thotypous/ll14x-power-supply/imagens/referencias/D_NQ_NP_2X_678878-MLA81993519998_022025-F-placa-potencia-lava-louca-ll10x-ll10b-a21846701-220v.webp

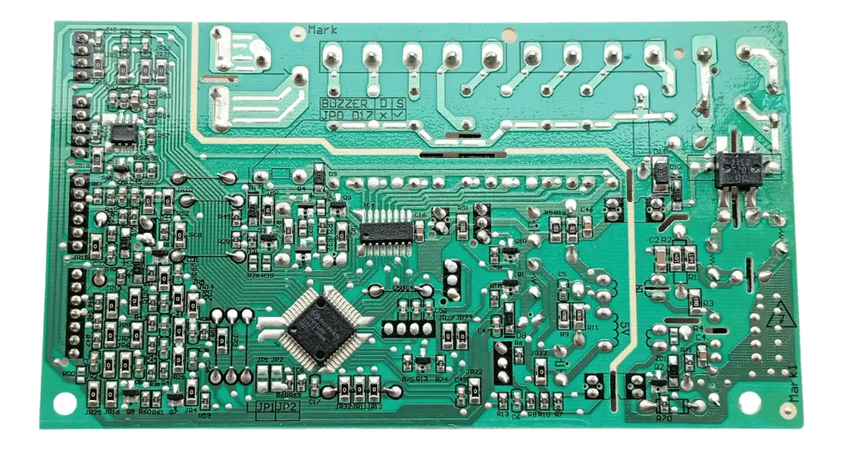
imagens/referencias/D_NQ_NP_2X_678878-MLA81993519998_022025-F-placa-potencia-lava-louca-ll10x-ll10b-a21846701-220v.webp
