thotypous/ll14x-power-supply/imagens/referencias/D_NQ_NP_2X_937345-MLB83347727536_042025-F-placa-lava-louca-electrolux--wqp127601sd11-v11.webp

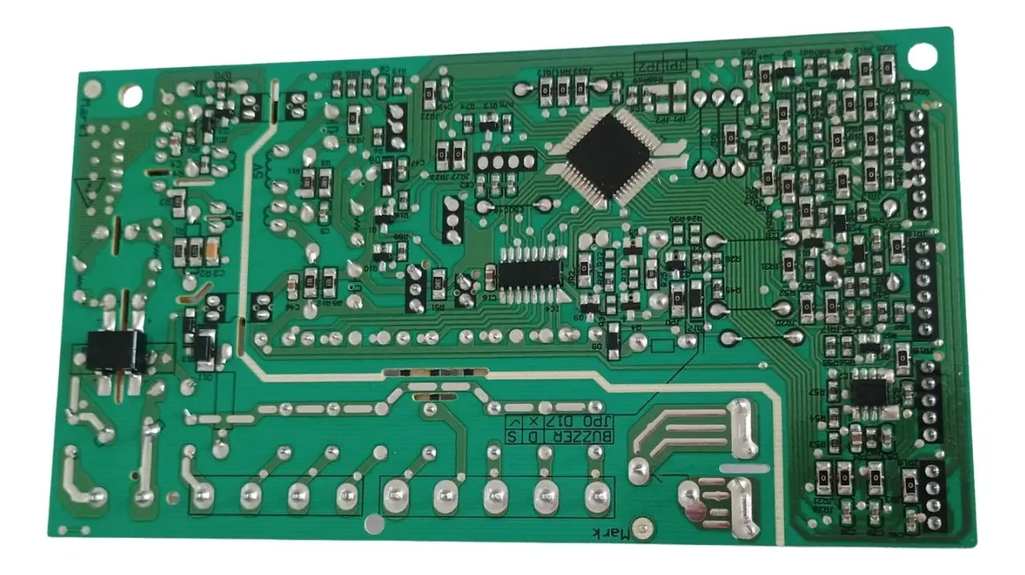
imagens/referencias/D_NQ_NP_2X_937345-MLB83347727536_042025-F-placa-lava-louca-electrolux--wqp127601sd11-v11.webp
