thotypous/ll14x-power-supply/imagens/originais/PXL_20260823_020516982.jpg

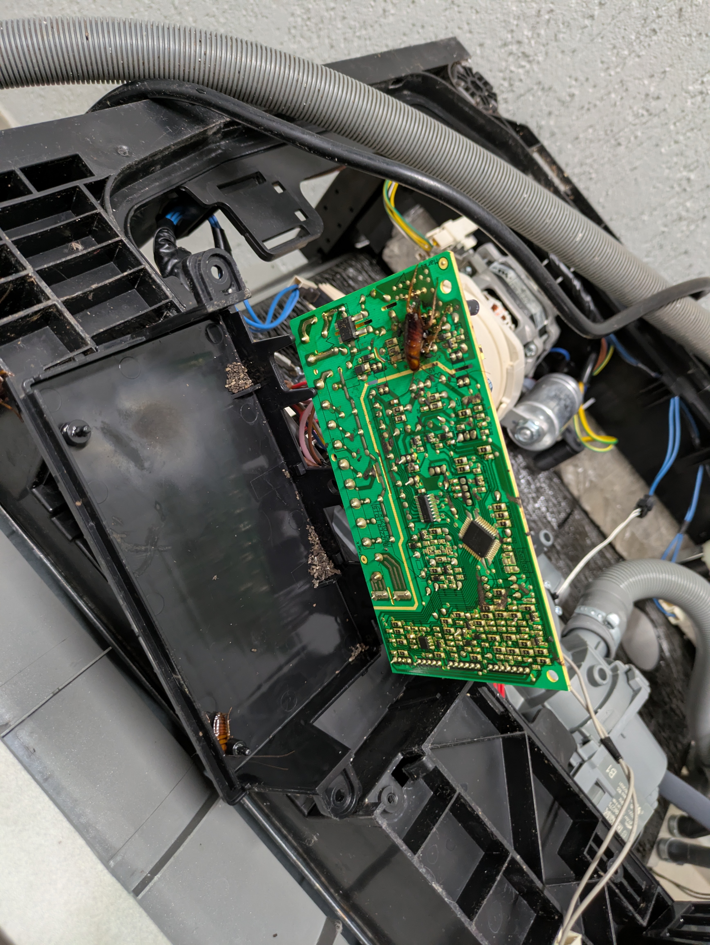
imagens/originais/PXL_20260823_020516982.jpg
