thotypous/ll14x-power-supply/imagens/originais/PXL_20260823_033906993.jpg

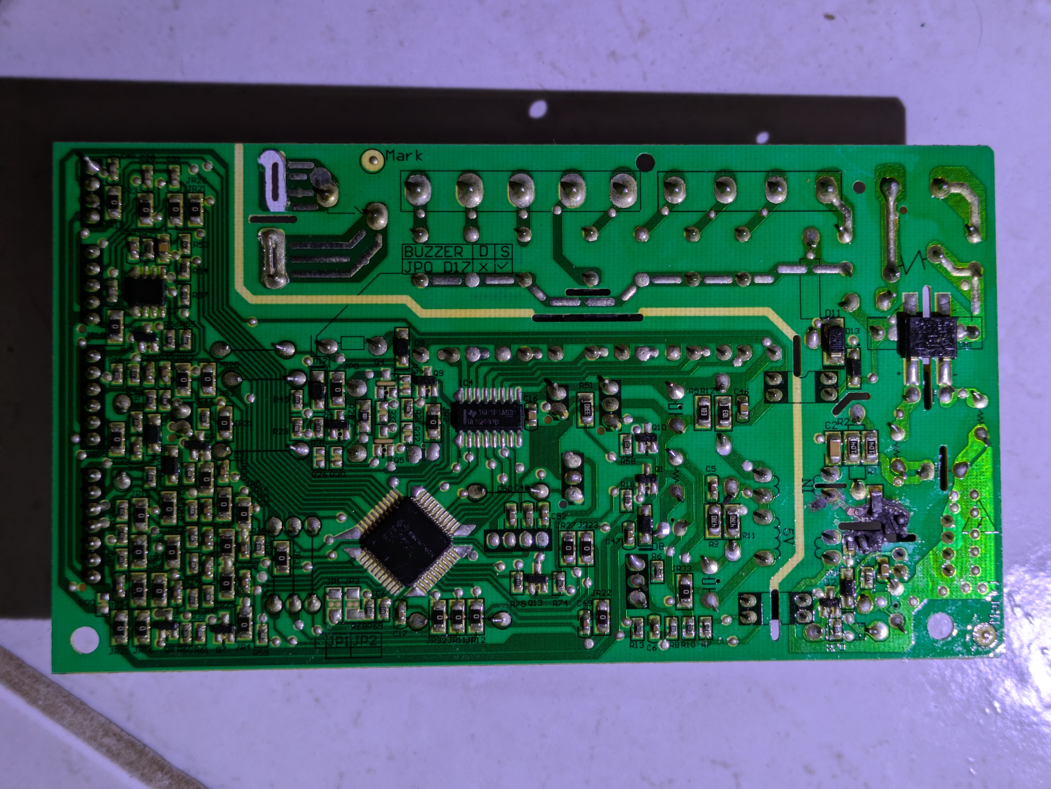
imagens/originais/PXL_20260823_033906993.jpg
