thotypous/ll14x-power-supply/imagens/originais/PXL_20260823_033933343.jpg

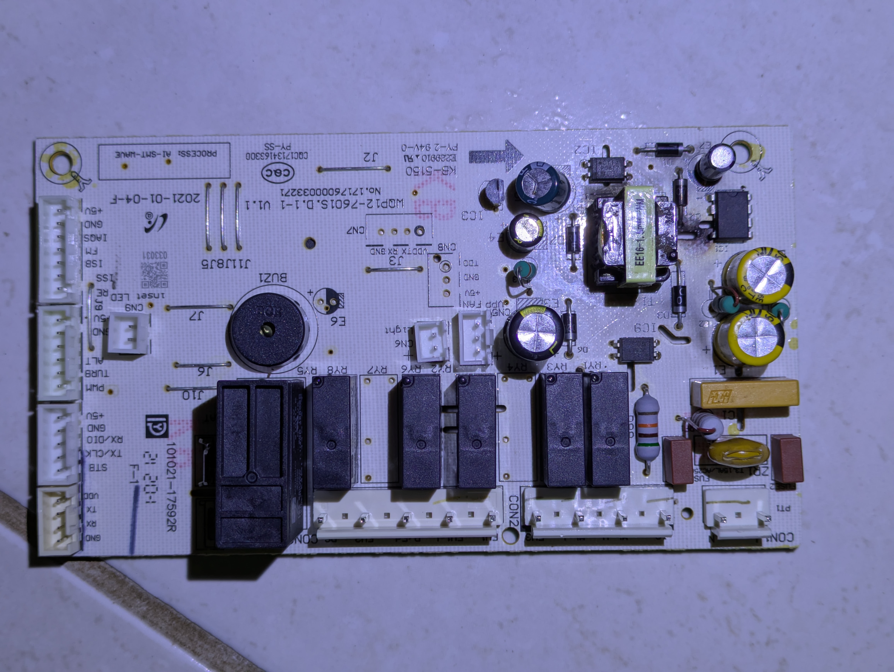
imagens/originais/PXL_20260823_033933343.jpg
