thotypous/ll14x-power-supply/imagens/referencias/D_NQ_NP_2X_705058-MLB76865311958_062024-F-placa-principal-lava-louca-midea-127v-codigo-17176000032220.webp

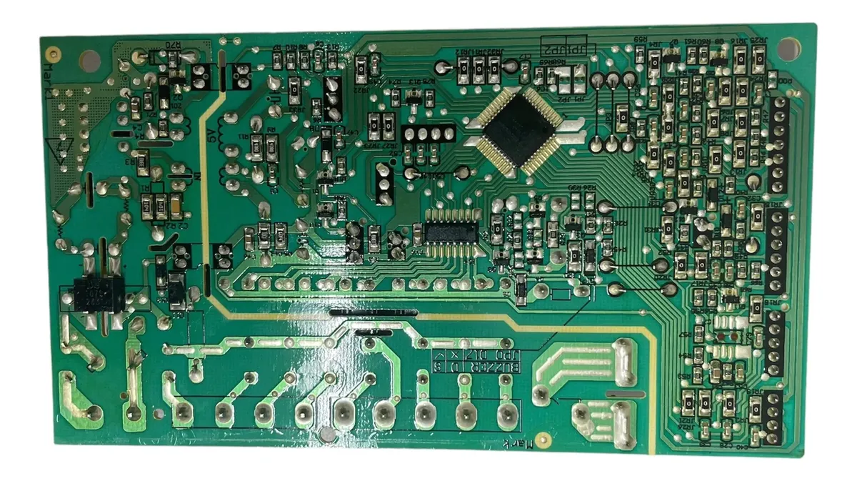
imagens/referencias/D_NQ_NP_2X_705058-MLB76865311958_062024-F-placa-principal-lava-louca-midea-127v-codigo-17176000032220.webp
