thotypous/ll14x-power-supply/imagens/referencias/D_NQ_NP_2X_771331-MLB103020104988_012026-F-placa-potencia-para-lava-loucas-continental-lc14s-original.webp

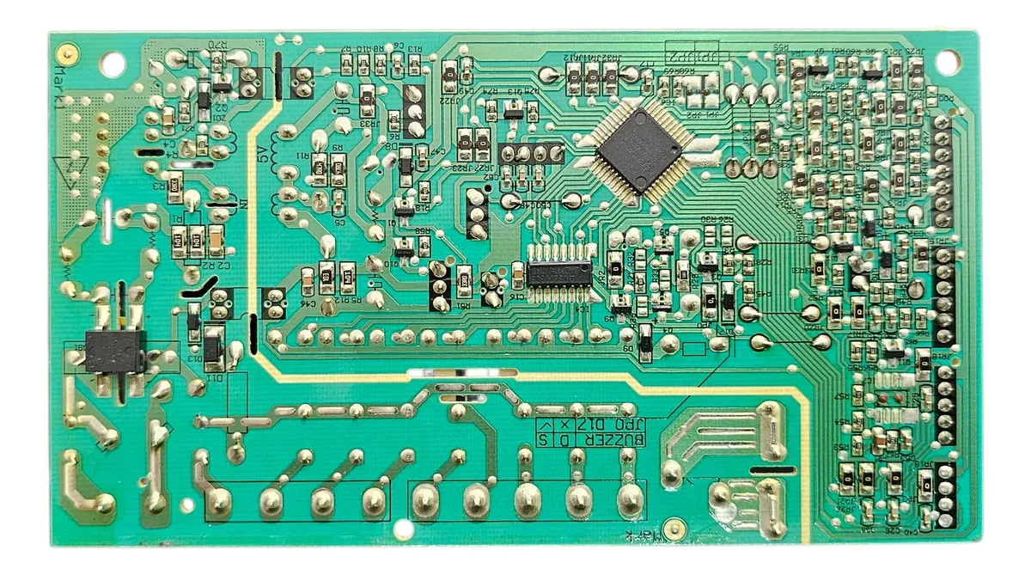
imagens/referencias/D_NQ_NP_2X_771331-MLB103020104988_012026-F-placa-potencia-para-lava-loucas-continental-lc14s-original.webp
