thotypous/ll14x-power-supply/imagens/referencias/D_NQ_NP_2X_939163-MLB111865523532_062026-F-placa-eletronica-da-lava-loucas-electrolux-220v-a21846701.webp

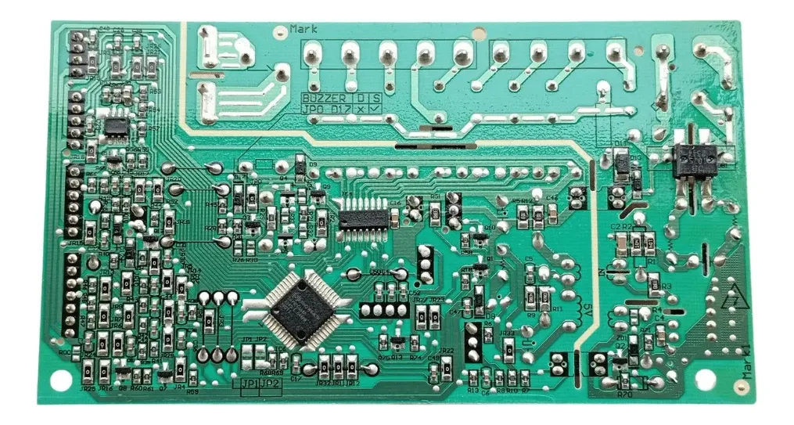
imagens/referencias/D_NQ_NP_2X_939163-MLB111865523532_062026-F-placa-eletronica-da-lava-loucas-electrolux-220v-a21846701.webp
