thotypous/ll14x-power-supply/imagens/referencias/D_NQ_NP_2X_979317-MLB54945828202_042023-F-placa-potencia-110v-lava-louca-philco-pll14b-pll14i-original.webp

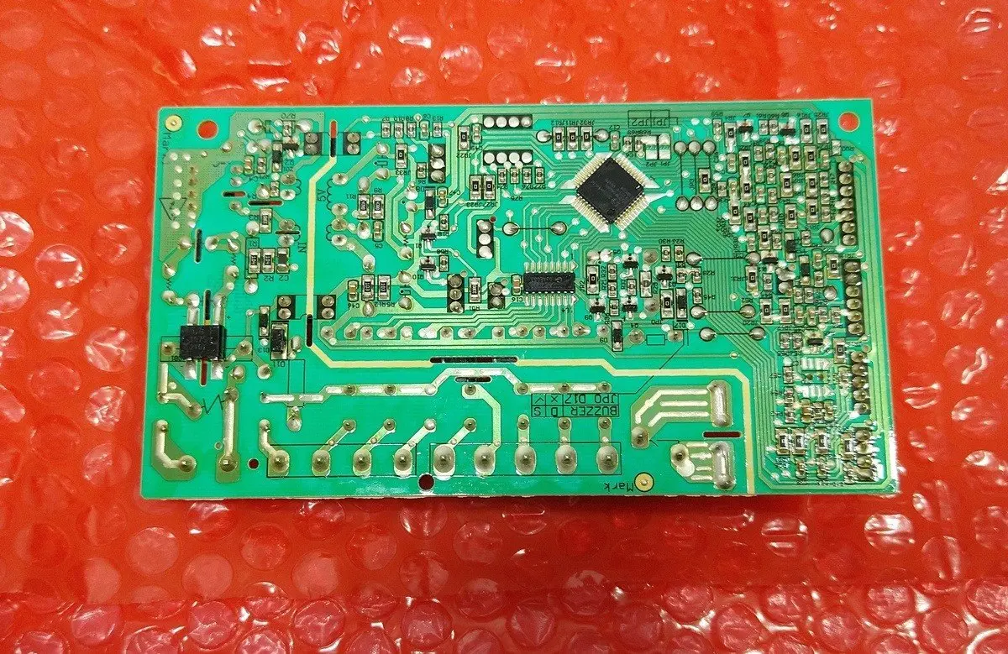
imagens/referencias/D_NQ_NP_2X_979317-MLB54945828202_042023-F-placa-potencia-110v-lava-louca-philco-pll14b-pll14i-original.webp
