thotypous/ll14x-power-supply/imagens/referencias/D_NQ_NP_2X_998180-MLB106133421512_022026-F-placa-de-potencia-220v-lavalouca-ll14p-electrolux-a21850501.webp

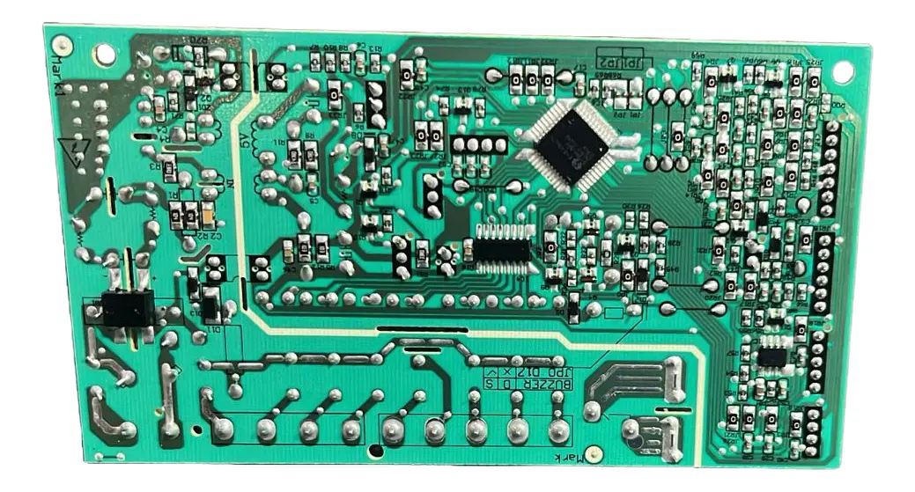
imagens/referencias/D_NQ_NP_2X_998180-MLB106133421512_022026-F-placa-de-potencia-220v-lavalouca-ll14p-electrolux-a21850501.webp
