thotypous/ll14x-power-supply/imagens/reparo/crop_reparo.jpg

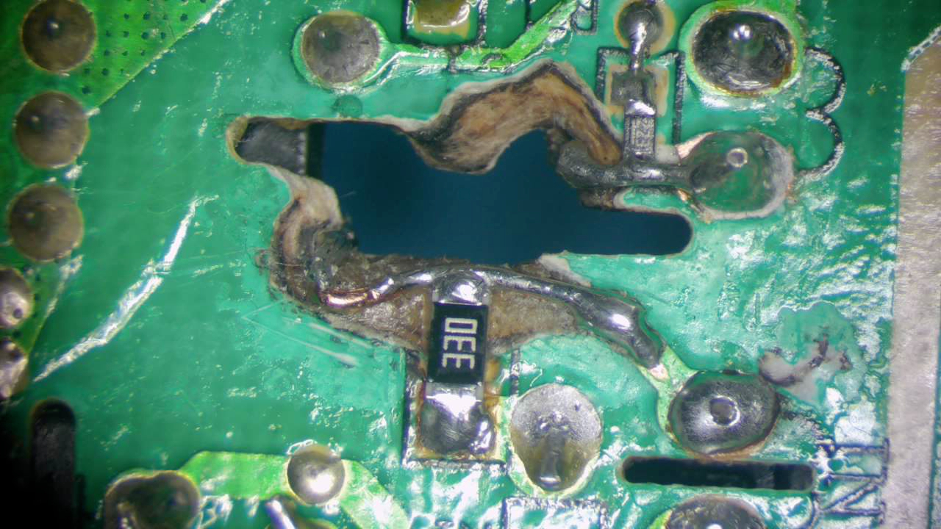
imagens/reparo/crop_reparo.jpg
